chipmc/Particle-Boron-Carrier-v1.4/README.md

# Particle-Boron-Carrier-v1.2a
 Updated and tested version of the carrier board.
