chipmc/Particle-Boron-Carrier-v1.4/Resistors and Caps.rtf

Resistors and Caps

Resistors

100ohm - R8, R9
4.7k - R4, R5
10k - R1, R7
100k - R6, R3

Caps
8.2pF - C12
10pF - C11
10nF - C4, C5
0.1uF - C1, C6, C7, C10
1uF - C2, C9
