chipmc/Particle-Boron-Carrier-v1.4/Datasheets/Rick's Original Schemetic.png

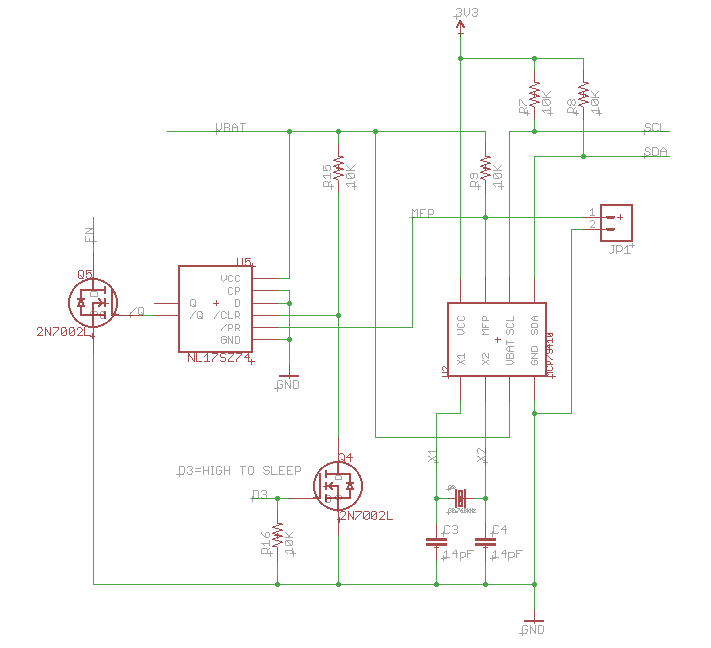
Datasheets/Rick's Original Schemetic.png
