chipmc/Particle-Boron-Carrier-v1.4/Carrier Board.brd

## EAGLE design Carrier Board.brd (2020-09-01)

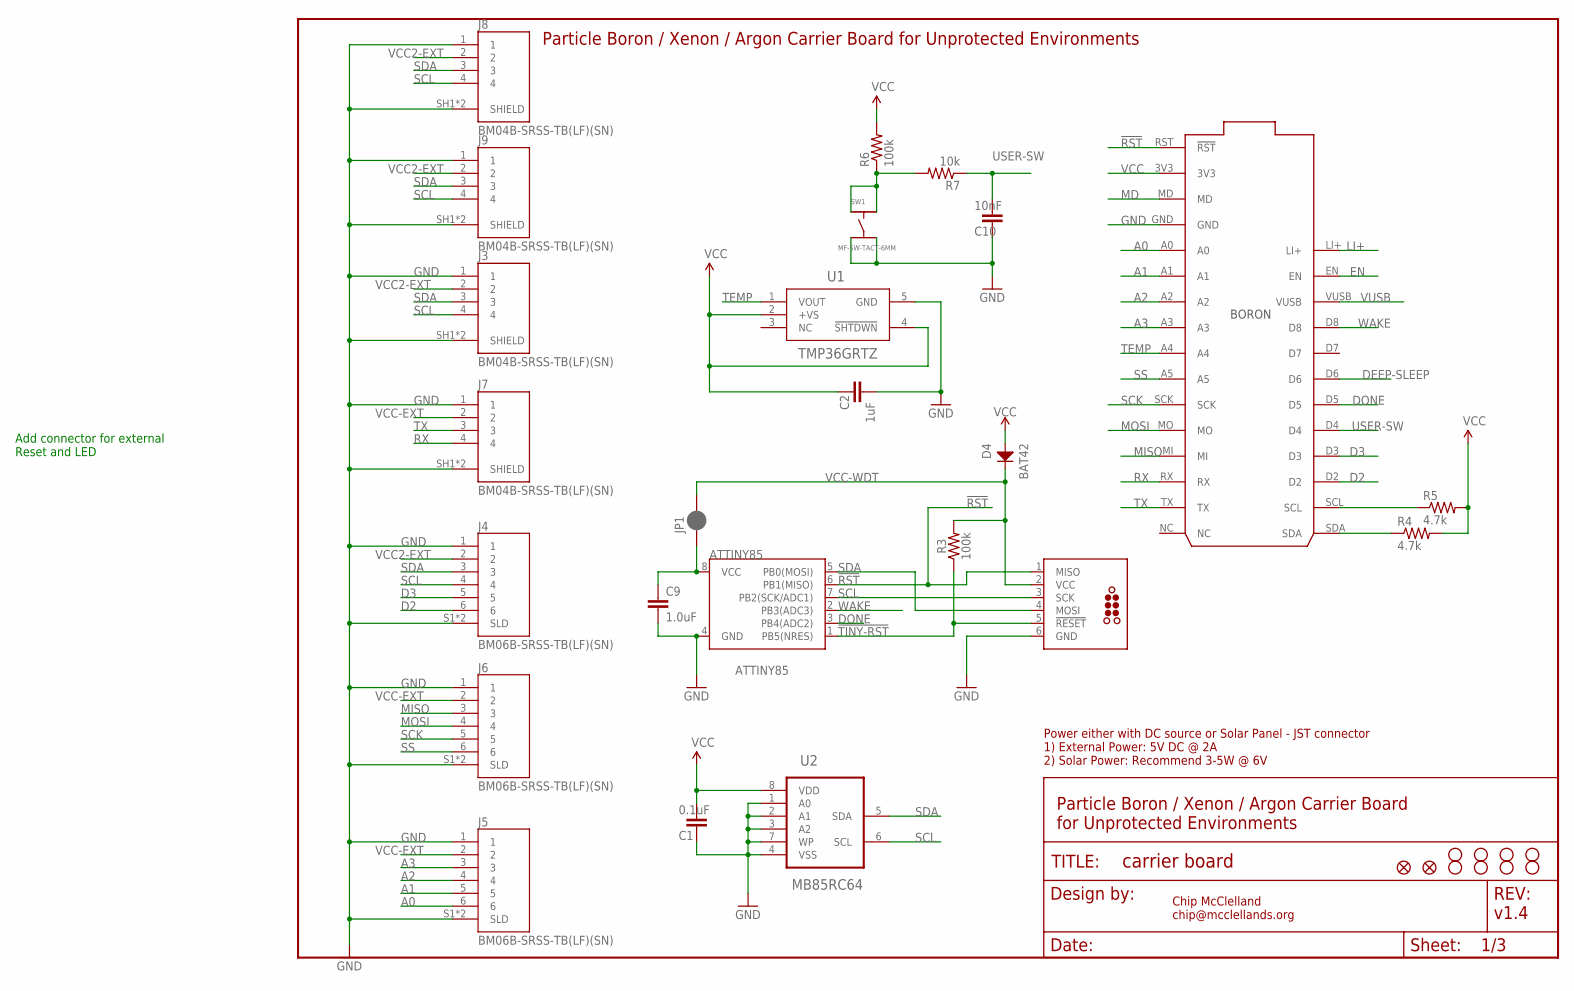
[picture p2: schematic Carrier Board.sch, sheet 1, Sensors]

Parts:
ATTINY85: ATTINY85; SO08-EIAJ; MPN ATTINY85-20SUR
C1: 0.1uF; 0805@1; MPN MF-CAP-0805-0.1uF
C2: 1uF; 0805@1; MPN MF-CAP-0805-1uF
C9: 1.0uF; 0805; MPN MF-CAP-0805-0.1uF
C10: 10nF; 0805@1; MPN 08051C103K4T2A
D4: BAT42; SOD-123
FD1, FD2: FIDUCIALUFIDUCIAL; FIDUCIAL-MICRO
FRAME1: FRAME-LETTER; CREATIVE_COMMONS
H1, H2, H3, H4: STAND-OFF-M2.5
ICSP: TCP2030-MCP-NL; TC2030-MCP-NL
J3, J7, J8, J9: BM04B-SRSS-TB(LF)(SN); CONN_BM04B-SRSS-TBT(LF)(SN)
J4, J5, J6: BM06B-SRSS-TB(LF)(SN); JST_BM06B-SRSS-TB(LF)(SN)
JP1: JUMPER-SMT_2_NC_PASTE_SILK; SMT-JUMPER_2_NC_PASTE_SILK
JP3, JP4, JP5, JP6: STAND-OFF
P1: Particle Boron / Xenon / Argon; PARTICLE-DEVICES_BORON
R3, R6: 100k; 0805; MPN MF-RES-0805-100K
R4, R5: 4.7k; 0805; MPN MF-RES-0805-4.7K
R7: 10k; 0805; MPN MF-RES-0805-10K
SW1: MF-SW-TACT-6MM; TACT6MM
U1: TMP36GRTZ; RJ_5; MANUFACTURER_PART_NUMBER TMP36GRTZ-REEL7
U2: MB85RC64; SOIC127P600X175-8N; MPN MB85RC64APNF-G-JNERE1

Connections:
!RST: ATTINY85.6 (PB1(MISO)), ICSP.1 (MISO), P1.RST (!RST)
!TINY-RST: ATTINY85.1 (PB5(NRES)), ICSP.5 (!RESET), R3.1
A0: J5.6, P1.A0
A1: J5.5, P1.A1
A2: J5.4, P1.A2
A3: J5.3, P1.A3
D2: J4.6, P1.D2; also elsewhere on the board
D3: J4.5, P1.D3; also elsewhere on the board
DEEP-SLEEP: P1.D6
DONE: ATTINY85.3 (PB4(ADC2)), P1.D5
EN: P1.EN; also elsewhere on the board
GND: ATTINY85.4 (GND), C1.2, C2.2, C9.2, C10.2, ICSP.6 (GND), J3.1, J3.SH1 (SHIELD), J3.SH2 (SHIELD), J4.1, J4.S1 (SLD), J4.S2 (SLD), J5.1, J5.S1 (SLD), J5.S2 (SLD), J6.1, J6.S1 (SLD), J6.S2 (SLD), J7.1, J7.SH1 (SHIELD), J7.SH2 (SHIELD), J8.1, J8.SH1 (SHIELD), J8.SH2 (SHIELD), J9.1, J9.SH1 (SHIELD), J9.SH2 (SHIELD), P1.GND, SW1.P$3, SW1.P$4, U1.5 (GND), U2.1 (A0), U2.2 (A1), U2.3 (A2), U2.4 (VSS), U2.7 (WP); also elsewhere on the board
LI+: P1.LI+; also elsewhere on the board
MD: P1.MD
MISO: J6.3, P1.MI
MOSI: J6.4, P1.MO
unnamed: R6.1, R7.2, SW1.P$1, SW1.P$2
unnamed: ATTINY85.8 (VCC), C9.1, JP1.1
RX: J7.4, P1.RX
SCK: J6.5, P1.SCK
SCL: ATTINY85.7 (PB2(SCK/ADC1)), ICSP.3 (SCK), J3.4, J4.4, J8.4, J9.4, P1.SCL, R5.1, U2.6 (SCL); also elsewhere on the board
SDA: ATTINY85.5 (PB0(MOSI)), ICSP.4 (MOSI), J3.3, J4.3, J8.3, J9.3, P1.SDA, R4.1, U2.5 (SDA); also elsewhere on the board
SS: J6.6, P1.A5
TEMP: P1.A4, U1.1 (VOUT)
TX: J7.3, P1.TX
USER-SW: C10.1, P1.D4, R7.1
VCC: C1.1, C2.1, D4.ANODE, P1.3V3, R4.2, R5.2, R6.2, U1.2 (+VS), U1.4 (!SHTDWN), U2.8 (VDD); also elsewhere on the board
VCC2-EXT: J3.2, J4.2, J8.2, J9.2; also elsewhere on the board
VCC-EXT: J5.2, J6.2, J7.2; also elsewhere on the board
VCC-WDT: D4.CATHODE, ICSP.2 (VCC), JP1.2, R3.2
VUSB: P1.VUSB; also elsewhere on the board
WAKE: ATTINY85.2 (PB3(ADC3)), P1.D8

Notes on the sheet:
Chip McClelland chip@mcclellands.org
v1.4
Power either with DC source or Solar Panel - JST connector 1) External Power: 5V DC @ 2A 2) Solar Power: Recommend 3-5W @ 6V
Particle Boron / Xenon / Argon Carrier Board for Unprotected Environments
Particle Boron / Xenon / Argon Carrier Board for Unprotected Environments
Add connector for external Reset and LED

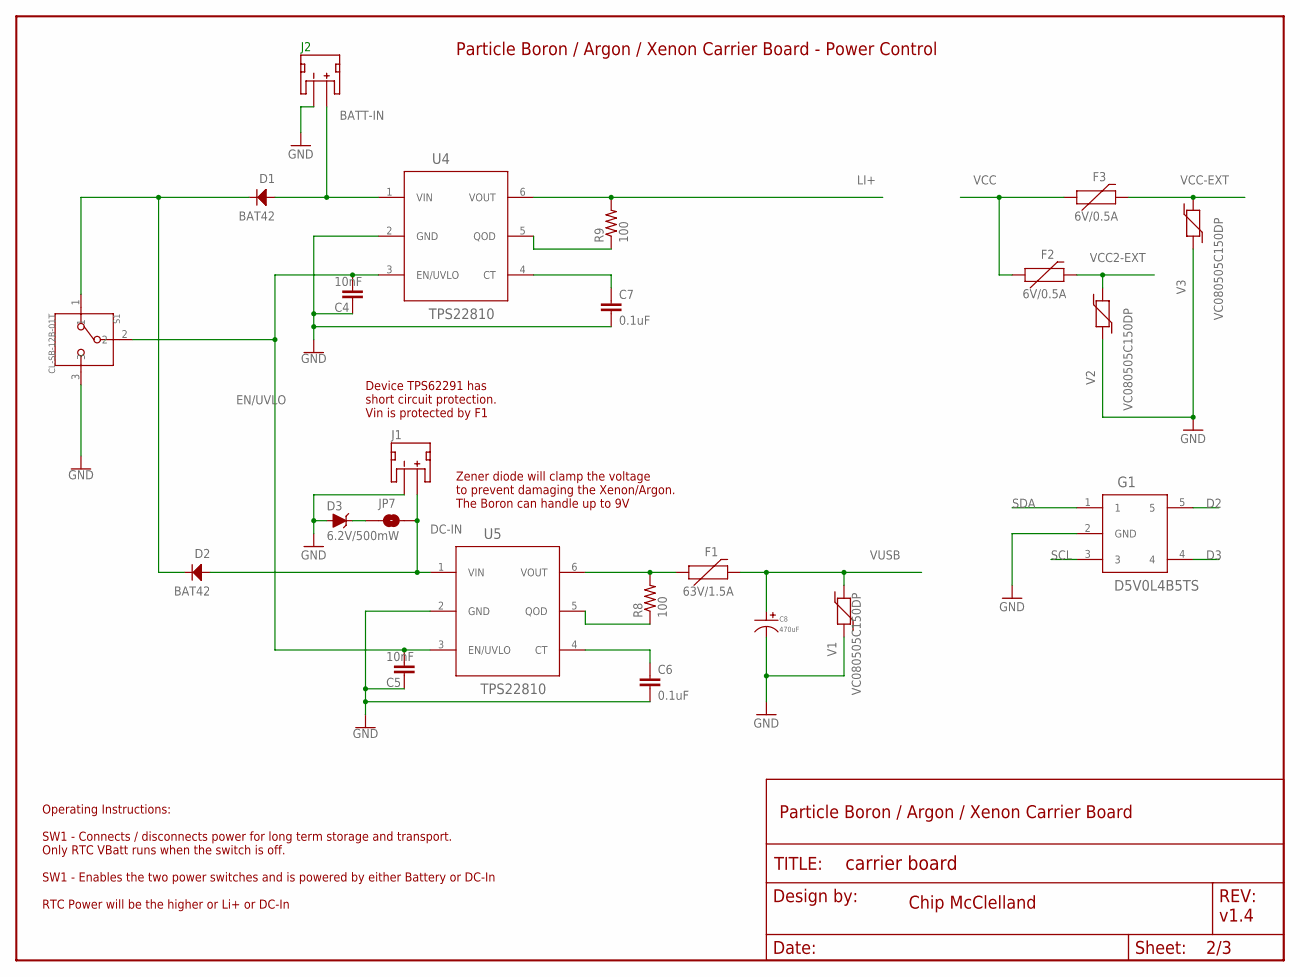
[picture p3: schematic Carrier Board.sch, sheet 2, Power Control]

Parts:
C4, C5: 10nF; 0805@1; MPN 08051C103K4T2A
C6, C7: 0.1uF; 0805@1; MPN MF-CAP-0805-0.1uF
C8: 470uF; CP10MM; MPN MF-CAP-10MM-470uF
D1, D2: BAT42; SOD-123
D3: 6.2V/500mW; PANASONIC_SMINI2-F5-B; MPN TDZ6V2J,115
F1: 63V/1.5A; 1206; MPN 046801.5NR
F2, F3: 6V/0.5A; 1206; MPN 0466.500NR
FRAME2: FRAME-LETTER; CREATIVE_COMMONS
G1: D5V0L4B5TS; SOT-23-5; MPN D5V0L4B5TS-7
J1, J2: S2B-PH-SM4-TB(LF)(SN); JST-2-SMD
JP7: JUMPER-SMT_2_NO_SILK; SMT-JUMPER_2_NO_SILK
R8, R9: 100; 0805; MPN MF-RES-0805-100
S1: CL-SB-12B-01T; CL-SB-12B
U4, U5: TPS22810; SOT-23-6; MPN TPS22810DBVT
V1, V2, V3: VC080505C150DP; 0805; MPN VC080505C150DP

Connections:
BATT-IN: D1.ANODE, J2.2 (+), U4.1 (VIN); also elsewhere on the board
D2: G1.5; also elsewhere on the board
D3: G1.4; also elsewhere on the board
DC-IN: D2.ANODE, J1.2 (+), JP7.1, U5.1 (VIN)
EN/UVLO: C4.1, C5.1, S1.2, U4.3 (EN/UVLO), U5.3 (EN/UVLO)
GND: C4.2, C5.2, C6.2, C7.2, C8.P$2, D3.A, G1.2 (GND), J1.1 (-), J2.1 (-), S1.3, U4.2 (GND), U5.2 (GND), V1.1, V2.1, V3.1; also elsewhere on the board
LI+: R9.2, U4.6 (VOUT); also elsewhere on the board
unnamed: D3.C, JP7.2
unnamed: C6.1, U5.4 (CT)
unnamed: R8.1, U5.5 (QOD)
unnamed: F1.1, R8.2, U5.6 (VOUT)
unnamed: D1.CATHODE, D2.CATHODE, S1.1
unnamed: C7.1, U4.4 (CT)
unnamed: R9.1, U4.5 (QOD)
SCL: G1.3; also elsewhere on the board
SDA: G1.1; also elsewhere on the board
VCC: F2.1, F3.1; also elsewhere on the board
VCC2-EXT: F2.2, V2.2; also elsewhere on the board
VCC-EXT: F3.2, V3.2; also elsewhere on the board
VUSB: C8.P$1, F1.2, V1.2; also elsewhere on the board

Notes on the sheet:
Particle Boron / Argon / Xenon Carrier Board - Power Control
Chip McClelland
v1.4
Device TPS62291 has short circuit protection. Vin is protected by F1
Particle Boron / Argon / Xenon Carrier Board
Operating Instructions: SW1 - Connects / disconnects power for long term storage and transport. Only RTC VBatt runs when the switch is off. SW1 - Enables the two power switches and is powered by either Battery or DC-In RTC Power will be the higher or Li+ or DC-In
Zener diode will clamp the voltage to prevent damaging the Xenon/Argon. The Boron can handle up to 9V

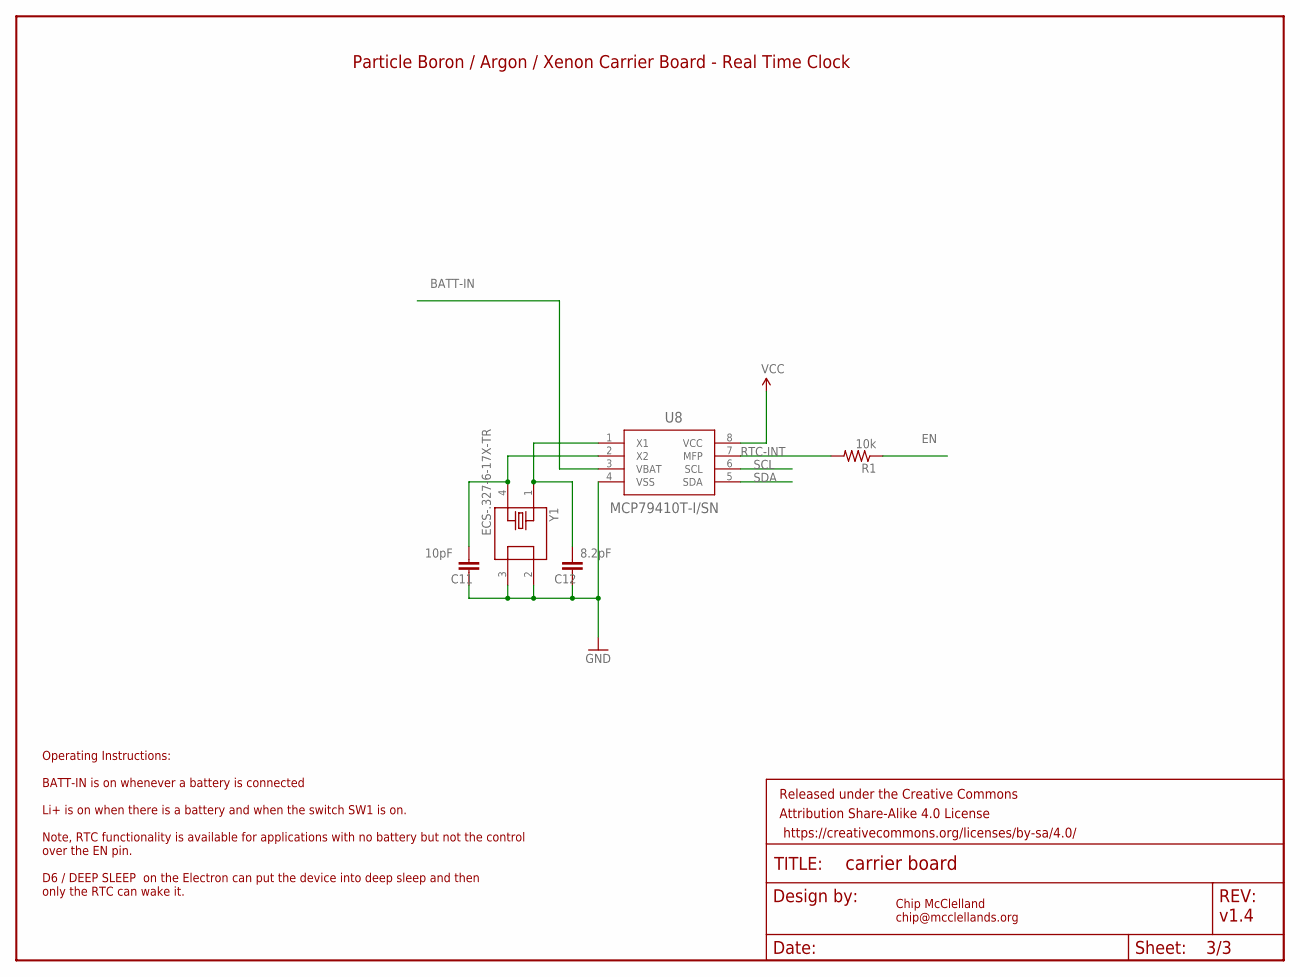
[picture p4: schematic Carrier Board.sch, sheet 3, Real Time Clock]

Parts:
C11: 10pF; 0805@1; MPN C0805C100JDGACTU‎
C12: 8.2pF; 0805@1; MPN C0805C829D5GACTU‎
FRAME3: FRAME-LETTER; CREATIVE_COMMONS
R1: 10k; 0805; MPN MF-RES-0805-10K
U8: MCP79410T-I/SN; SOIC8-N_MC
Y1: ECS-.327-6-17X-TR; XTAL_ECS-.327-6-17X-TR

Connections:
BATT-IN: U8.3 (VBAT); also elsewhere on the board
EN: R1.1; also elsewhere on the board
GND: C11.2, C12.2, U8.4 (VSS), Y1.2, Y1.3; also elsewhere on the board
unnamed: C12.1, U8.1 (X1), Y1.1
unnamed: C11.1, U8.2 (X2), Y1.4
RTC-INT: R1.2, U8.7 (MFP)
SCL: U8.6 (SCL); also elsewhere on the board
SDA: U8.5 (SDA); also elsewhere on the board
VCC: U8.8 (VCC); also elsewhere on the board

Notes on the sheet:
Operating Instructions: BATT-IN is on whenever a battery is connected Li+ is on when there is a battery and when the switch SW1 is on. Note, RTC functionality is available for applications with no battery but not the control over the EN pin. D6 / DEEP SLEEP on the Electron can put the device into d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
Particle Boron / Argon / Xenon Carrier Board - Real Time Clock
Chip McClelland chip@mcclellands.org
v1.4

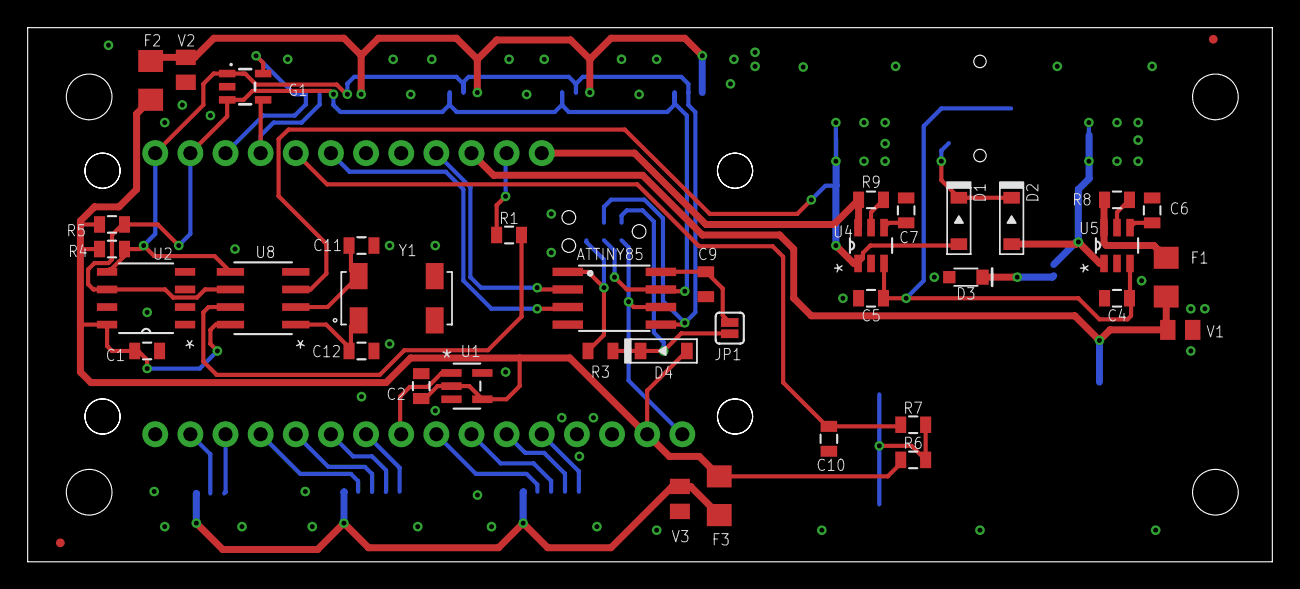
[picture p5: board Carrier Board.brd from above]

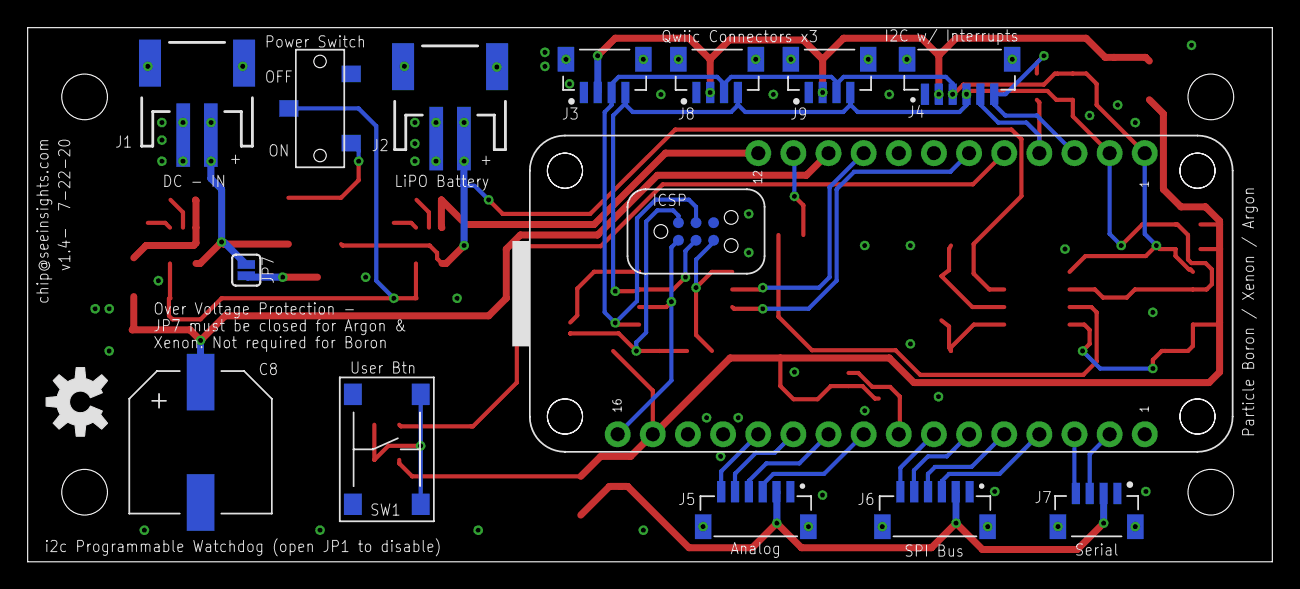
[picture p6: board Carrier Board.brd from below]

Board: 2 copper layers, 90.0 x 38.6 mm, 66 parts (16 on the bottom side), 43 nets.

Other parts of the board:
U$2: OSHW-LOGO-M
